MrFlakey/smart-room-energy/hardware/pcb/render-bottom.png

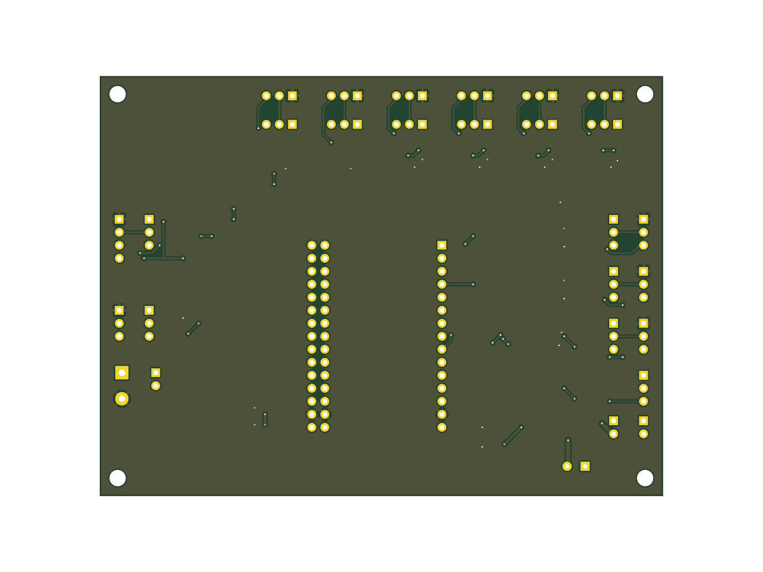
hardware/pcb/render-bottom.png
