MrFlakey/smart-room-energy/hardware/pcb/smart-room-carrier.kicad_sch

## KiCad design hardware/pcb/smart-room-carrier.kicad_sch (2026-10-20)

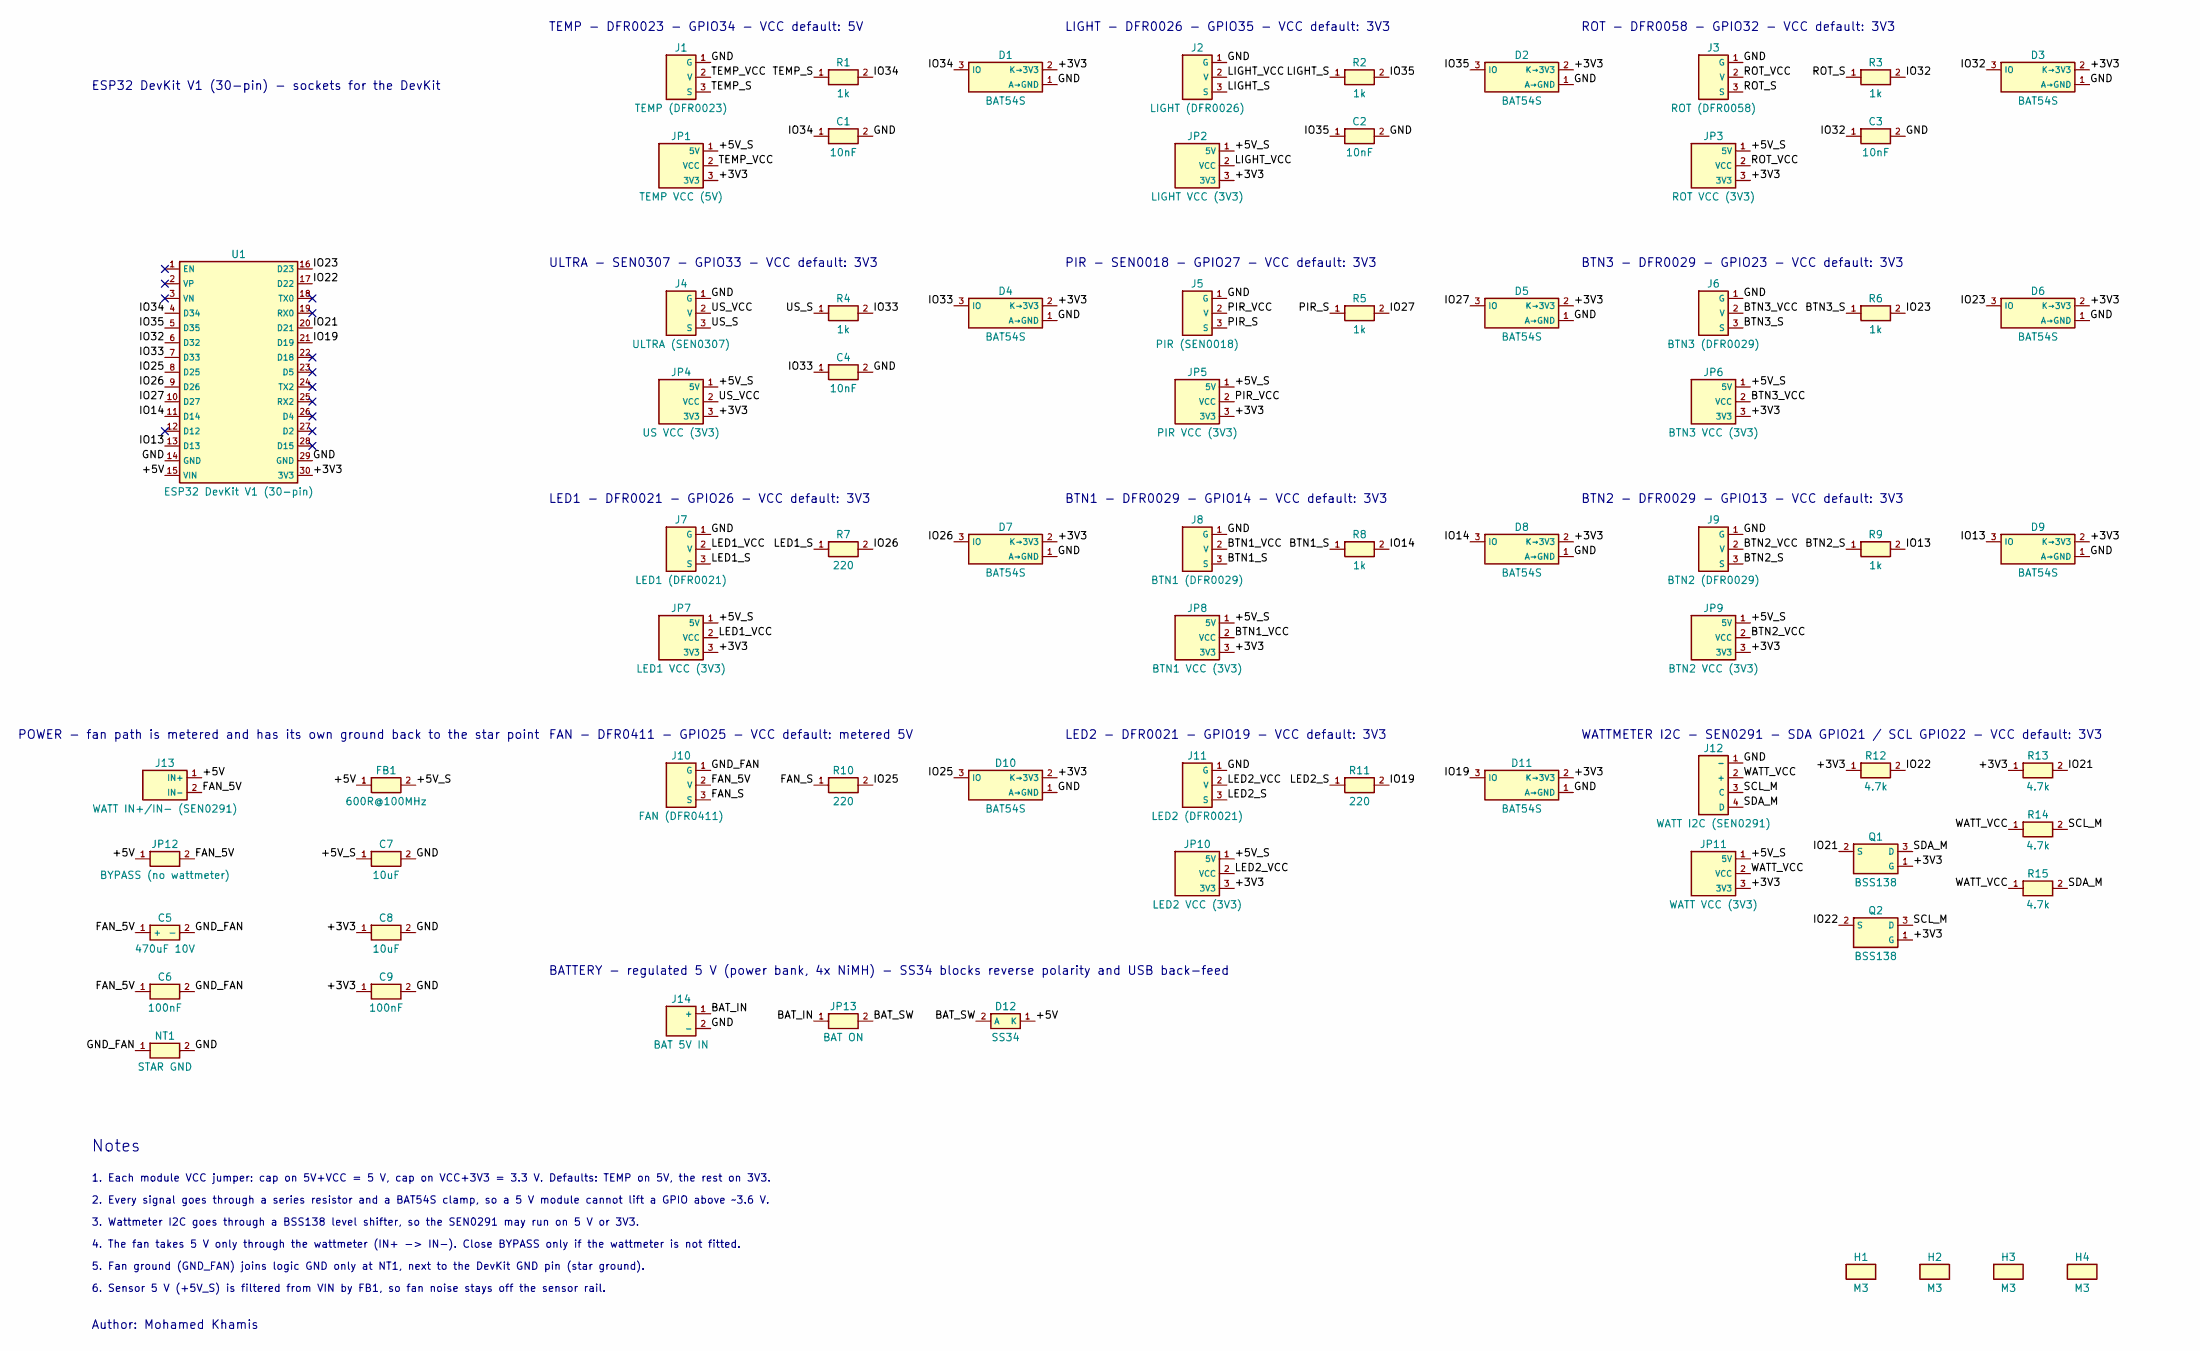
[picture p2: schematic smart-room-carrier.kicad_sch]

Parts:
C1, C2, C3, C4: 10nF; C_0805_HandSolder; Part 0805 X7R
C5: 470uF 10V; CP_Radial_D8.0mm_P3.50mm; Part Electrolytic 470uF 10V D8
C6, C9: 100nF; C_0805_HandSolder; Part 0805 X7R
C7, C8: 10uF; C_0805_HandSolder; Part 0805 X5R 16V
D1, D2, D3, D4, D5, D6, D7, D8, D9, D10, D11: BAT54S; SOT-23; Part BAT54S
D12: SS34; D_SMA; Part SS34 (3 A, 40 V Schottky)
FB1: 600R@100MHz; L_0805_HandSolder; Part 0805 ferrite bead, >=500 mA
H1, H2, H3, H4: M3; MountingHole_3.2mm_M3
J1: TEMP (DFR0023); PinHeader_1x03_P2.54mm; Part 1x03 male header 2.54 mm
J2: LIGHT (DFR0026); PinHeader_1x03_P2.54mm; Part 1x03 male header 2.54 mm
J3: ROT (DFR0058); PinHeader_1x03_P2.54mm; Part 1x03 male header 2.54 mm
J4: ULTRA (SEN0307); PinHeader_1x03_P2.54mm; Part 1x03 male header 2.54 mm
J5: PIR (SEN0018); PinHeader_1x03_P2.54mm; Part 1x03 male header 2.54 mm
J6: BTN3 (DFR0029); PinHeader_1x03_P2.54mm; Part 1x03 male header 2.54 mm
J7: LED1 (DFR0021); PinHeader_1x03_P2.54mm; Part 1x03 male header 2.54 mm
J8: BTN1 (DFR0029); PinHeader_1x03_P2.54mm; Part 1x03 male header 2.54 mm
J9: BTN2 (DFR0029); PinHeader_1x03_P2.54mm; Part 1x03 male header 2.54 mm
J10: FAN (DFR0411); PinHeader_1x03_P2.54mm; Part 1x03 male header 2.54 mm
J11: LED2 (DFR0021); PinHeader_1x03_P2.54mm; Part 1x03 male header 2.54 mm
J12: WATT I2C (SEN0291); PinHeader_1x04_P2.54mm; Part 1x04 male header 2.54 mm
J13: WATT IN+/IN- (SEN0291); PinHeader_1x02_P2.54mm; Part 1x02 male header 2.54 mm
J14: BAT 5V IN; TerminalBlock_1x02_P5.08mm; Part 2-pin screw terminal 5.08 mm
JP1: TEMP VCC (5V); PinHeader_1x03_P2.54mm; Part 1x03 male header + jumper cap
JP2: LIGHT VCC (3V3); PinHeader_1x03_P2.54mm; Part 1x03 male header + jumper cap
JP3: ROT VCC (3V3); PinHeader_1x03_P2.54mm; Part 1x03 male header + jumper cap
JP4: US VCC (3V3); PinHeader_1x03_P2.54mm; Part 1x03 male header + jumper cap
JP5: PIR VCC (3V3); PinHeader_1x03_P2.54mm; Part 1x03 male header + jumper cap
JP6: BTN3 VCC (3V3); PinHeader_1x03_P2.54mm; Part 1x03 male header + jumper cap
JP7: LED1 VCC (3V3); PinHeader_1x03_P2.54mm; Part 1x03 male header + jumper cap
JP8: BTN1 VCC (3V3); PinHeader_1x03_P2.54mm; Part 1x03 male header + jumper cap
JP9: BTN2 VCC (3V3); PinHeader_1x03_P2.54mm; Part 1x03 male header + jumper cap
JP10: LED2 VCC (3V3); PinHeader_1x03_P2.54mm; Part 1x03 male header + jumper cap
JP11: WATT VCC (3V3); PinHeader_1x03_P2.54mm; Part 1x03 male header + jumper cap
JP12: BYPASS (no wattmeter); PinHeader_1x02_P2.54mm; Part 1x02 male header + jumper cap
JP13: BAT ON; PinHeader_1x02_P2.54mm; Part 1x02 male header + jumper cap (or exter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
NT1: STAR GND; NetTie_2_Pad1.0mm; Part (copper only)
Q1, Q2: BSS138; SOT-23; Part BSS138
R1, R2, R3, R4, R5, R6, R8, R9: 1k; R_0805_HandSolder; Part 0805 1%
R7, R10, R11: 220; R_0805_HandSolder; Part 0805 1%
R12, R13, R14, R15: 4.7k; R_0805_HandSolder; Part 0805 1%
U1: ESP32 DevKit V1 (30-pin); ESP32_DevKitV1_30pin_Socket; Part 2x 1x15 female header, 2.54 mm

Connections:
+3V3: C8.1, C9.1, D1.2 (K→3V3), D2.2 (K→3V3), D3.2 (K→3V3), D4.2 (K→3V3), D5.2 (K→3V3), D6.2 (K→3V3), D7.2 (K→3V3), D8.2 (K→3V3), D9.2 (K→3V3), D10.2 (K→3V3), D11.2 (K→3V3), JP1.3 (3V3), JP2.3 (3V3), JP3.3 (3V3), JP4.3 (3V3), JP5.3 (3V3), JP6.3 (3V3), JP7.3 (3V3), JP8.3 (3V3), JP9.3 (3V3), JP10.3 (3V3), JP11.3 (3V3), Q1.1 (G), Q2.1 (G), R12.1, R13.1, U1.30 (3V3)
+5V: D12.1 (K), FB1.1, J13.1 (IN+), JP12.1, U1.15 (VIN)
+5V_S: C7.1, FB1.2, JP1.1 (5V), JP2.1 (5V), JP3.1 (5V), JP4.1 (5V), JP5.1 (5V), JP6.1 (5V), JP7.1 (5V), JP8.1 (5V), JP9.1 (5V), JP10.1 (5V), JP11.1 (5V)
BAT_IN: J14.1 (+), JP13.1
BAT_SW: D12.2 (A), JP13.2
BTN1_S: J8.3 (S), R8.1
BTN1_VCC: J8.2 (V), JP8.2 (VCC)
BTN2_S: J9.3 (S), R9.1
BTN2_VCC: J9.2 (V), JP9.2 (VCC)
BTN3_S: J6.3 (S), R6.1
BTN3_VCC: J6.2 (V), JP6.2 (VCC)
FAN_5V: C5.1 (+), C6.1, J10.2 (V), J13.2 (IN-), JP12.2
FAN_S: J10.3 (S), R10.1
GND: C1.2, C2.2, C3.2, C4.2, C7.2, C8.2, C9.2, D1.1 (A→GND), D2.1 (A→GND), D3.1 (A→GND), D4.1 (A→GND), D5.1 (A→GND), D6.1 (A→GND), D7.1 (A→GND), D8.1 (A→GND), D9.1 (A→GND), D10.1 (A→GND), D11.1 (A→GND), J1.1 (G), J2.1 (G), J3.1 (G), J4.1 (G), J5.1 (G), J6.1 (G), J7.1 (G), J8.1 (G), J9.1 (G), J11.1 (G), J12.1 (-), J14.2 (-), NT1.2, U1.14 (GND), U1.29 (GND)
GND_FAN: C5.2 (-), C6.2, J10.1 (G), NT1.1
IO13: D9.3 (IO), R9.2, U1.13 (D13)
IO14: D8.3 (IO), R8.2, U1.11 (D14)
IO19: D11.3 (IO), R11.2, U1.21 (D19)
IO21: Q1.2 (S), R13.2, U1.20 (D21)
IO22: Q2.2 (S), R12.2, U1.17 (D22)
IO23: D6.3 (IO), R6.2, U1.16 (D23)
IO25: D10.3 (IO), R10.2, U1.8 (D25)
IO26: D7.3 (IO), R7.2, U1.9 (D26)
IO27: D5.3 (IO), R5.2, U1.10 (D27)
IO32: C3.1, D3.3 (IO), R3.2, U1.6 (D32)
IO33: C4.1, D4.3 (IO), R4.2, U1.7 (D33)
IO34: C1.1, D1.3 (IO), R1.2, U1.4 (D34)
IO35: C2.1, D2.3 (IO), R2.2, U1.5 (D35)
LED1_S: J7.3 (S), R7.1
LED1_VCC: J7.2 (V), JP7.2 (VCC)
LED2_S: J11.3 (S), R11.1
LED2_VCC: J11.2 (V), JP10.2 (VCC)
LIGHT_S: J2.3 (S), R2.1
LIGHT_VCC: J2.2 (V), JP2.2 (VCC)
PIR_S: J5.3 (S), R5.1
PIR_VCC: J5.2 (V), JP5.2 (VCC)
ROT_S: J3.3 (S), R3.1
ROT_VCC: J3.2 (V), JP3.2 (VCC)
SCL_M: J12.3 (C), Q2.3 (D), R14.2
SDA_M: J12.4 (D), Q1.3 (D), R15.2
TEMP_S: J1.3 (S), R1.1
TEMP_VCC: J1.2 (V), JP1.2 (VCC)
US_S: J4.3 (S), R4.1
US_VCC: J4.2 (V), JP4.2 (VCC)
WATT_VCC: J12.2 (+), JP11.2 (VCC), R14.1, R15.1

Notes on the sheet:
TEMP - DFR0023 - GPIO34 - VCC default: 5V
LIGHT - DFR0026 - GPIO35 - VCC default: 3V3
ROT - DFR0058 - GPIO32 - VCC default: 3V3
ULTRA - SEN0307 - GPIO33 - VCC default: 3V3
PIR - SEN0018 - GPIO27 - VCC default: 3V3
BTN3 - DFR0029 - GPIO23 - VCC default: 3V3
LED1 - DFR0021 - GPIO26 - VCC default: 3V3
BTN1 - DFR0029 - GPIO14 - VCC default: 3V3
BTN2 - DFR0029 - GPIO13 - VCC default: 3V3
FAN - DFR0411 - GPIO25 - VCC default: metered 5V
LED2 - DFR0021 - GPIO19 - VCC default: 3V3
WATTMETER I2C - SEN0291 - SDA GPIO21 / SCL GPIO22 - VCC default: 3V3
POWER - fan path is metered and has its own ground back to the star point
BATTERY - regulated 5 V (power bank, 4x NiMH) - SS34 blocks reverse polarity and USB back-feed
ESP32 DevKit V1 (30-pin) - sockets for the DevKit
Notes
1. Each module VCC jumper: cap on 5V+VCC = 5 V, cap on VCC+3V3 = 3.3 V. Defaults: TEMP on 5V, the rest on 3V3.
2. Every signal goes through a series resistor and a BAT54S clamp, so a 5 V module cannot lift a GPIO above ~3.6 V.
3. Wattmeter I2C goes through a BSS138 level shifter, so the SEN0291 may run on 5 V or 3V3.
4. The fan takes 5 V only through the wattmeter (IN+ -> IN-). Close BYPASS only if the wattmeter is not fitted.
5. Fan ground (GND_FAN) joins logic GND only at NT1, next to the DevKit GND pin (star ground).
6. Sensor 5 V (+5V_S) is filtered from VIN by FB1, so fan noise stays off the sensor rail.
Author: Mohamed Khamis
