MrFlakey/smart-room-energy/(commit log)

2026-09-29 Initial commit: ESP32 smart room energy firmware, docs and plan
2026-09-29 Update to ESP32 DevKit v1 as the default board
    Adds ESP32, fan and wattmeter wiring docs; updates pin map, config,
    PlatformIO default env, main loop, README and MQTT contract.
2026-10-01 Replace PlatformIO firmware with ESP-IDF v6.0 driver components
    Drivers for every sensor and actuator, one component each under
    firmware/components. main/ is an empty app_main plus the pin map.
    [analog_in.c, analog_in.h, board_pins.h, button.c, button.h, fan.c, fan.h, hcsr04.c]
2026-10-01 Add PIR + fan test to main
2026-10-02 Add a README for each driver and combine them in firmware/README.md
2026-10-04 Rewrite README for the ESP-IDF driver project
2026-10-20 Add SEN0307 ultrasonic driver, sensors, control loop and Wi-Fi/MQTT networking
    Replace the HC-SR04 driver with the DFRobot SEN0307 analog ultrasonic sensor,
    split main into sensors, control, room_data and net modules, and add a
    Smart Room menuconfig menu for Wi-Fi, MQTT broker and room id.
2026-10-20 Add KiCad carrier PCB for the ESP32 DevKit V1
    Schematic, board layout, custom footprint/symbol library, generator scripts,
    DRC/ERC reports, renders and fabrication gerbers.
2026-10-20 Update README and ESP32 wiring guide for the new sensors and PCB
